axelbrons/NeuralSpeech/src/README.md

# Les codes sources du projet
Tous les codes sources Arduino et Python en vrac.  
GitHub avec des codes en plus par l'ECE : [https://github.com/ElectroniqueECE/Projet_ING3/tree/main]
