axelbrons/NeuralSpeech/src/python/readme_python.md

# Les fichiers python (réseau de neurones)
