axelbrons/NeuralSpeech/src/datasets/readme_dataset.md

# Les datasets utilisés pour le réseau de neurones
