axelbrons/NeuralSpeech/docs/schemas/readme_schema.md

# Les schémas pour la compréhension du projet
