axelbrons/NeuralSpeech/docs/images/4khz.png

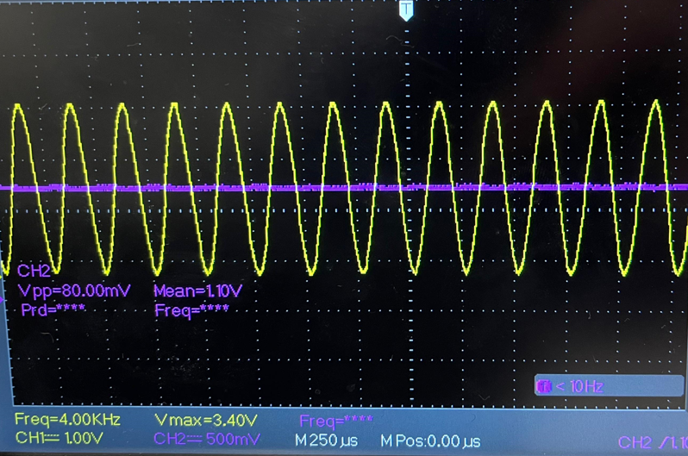
docs/images/4khz.png
