axelbrons/NeuralSpeech/docs/images/freq1.png

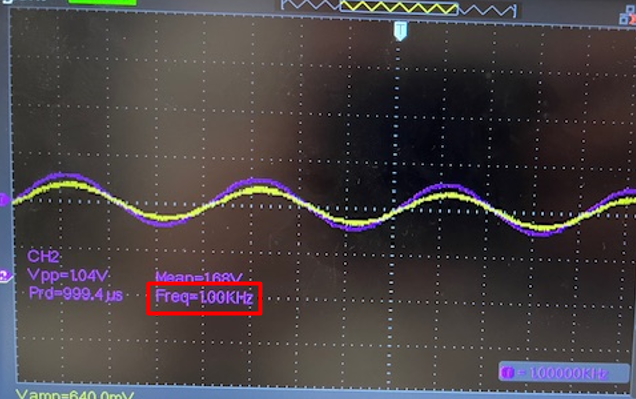
docs/images/freq1.png
