axelbrons/NeuralSpeech/docs/schemas/algo_cnn.png

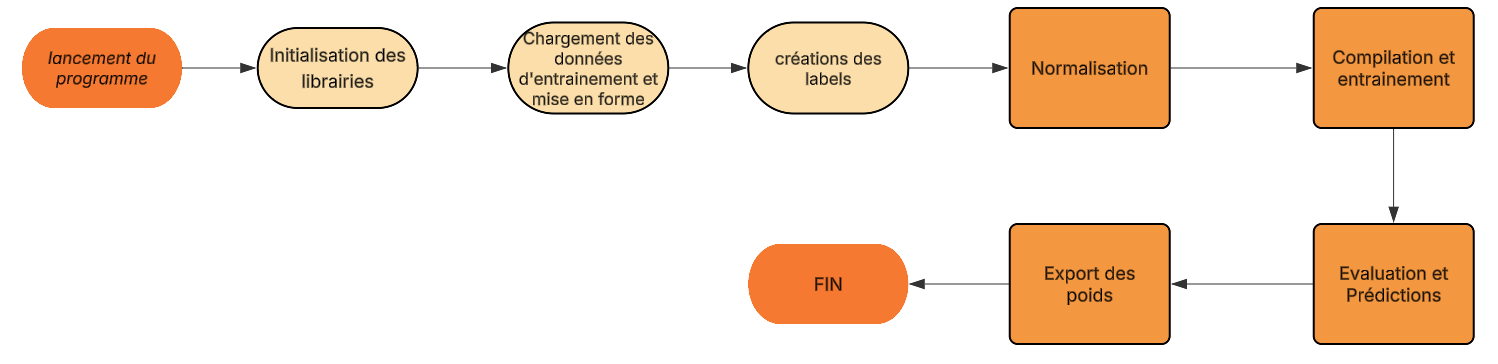
docs/schemas/algo_cnn.png
