axelbrons/NeuralSpeech/docs/schemas/algo_prediction.png

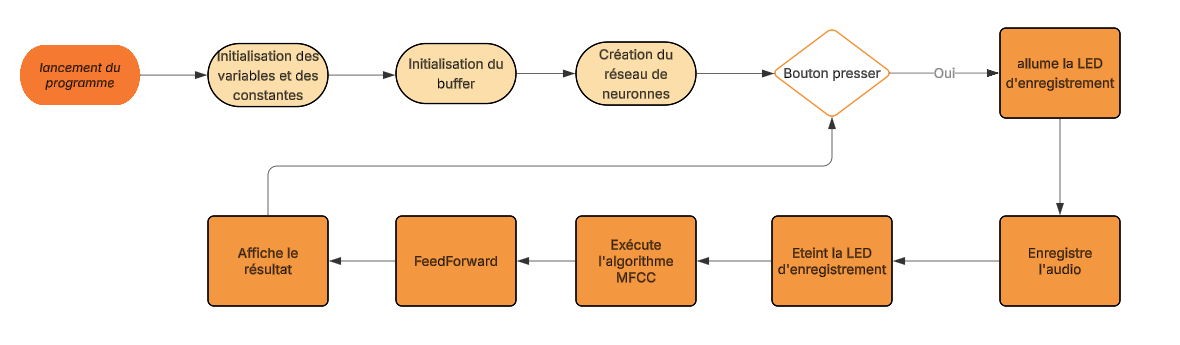
docs/schemas/algo_prediction.png
