axelbrons/NeuralSpeech/docs/schemas/algorigramme_enregistrement.png

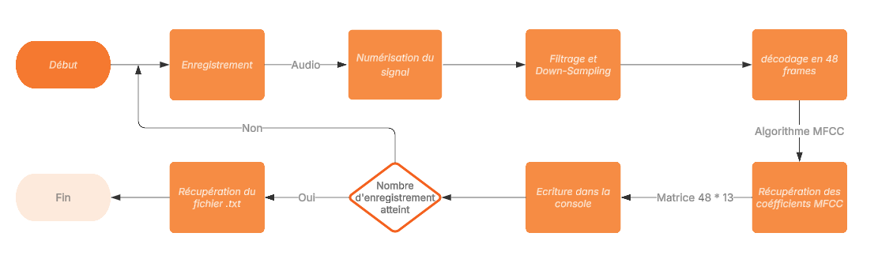
docs/schemas/algorigramme_enregistrement.png
