axelbrons/NeuralSpeech/docs/schemas/loss_1.png

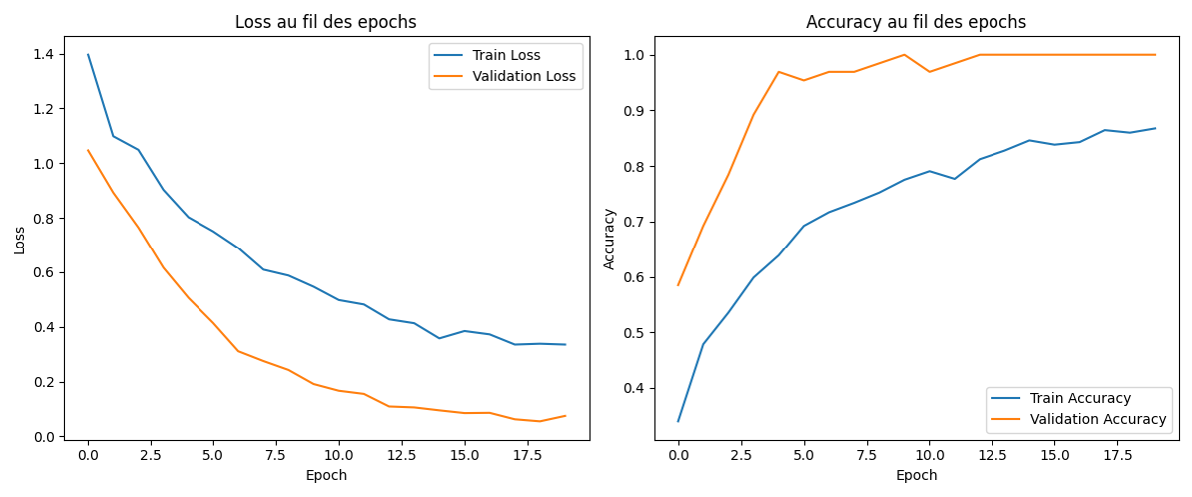
docs/schemas/loss_1.png
