axelbrons/NeuralSpeech/docs/schemas/recouvrement.jpg

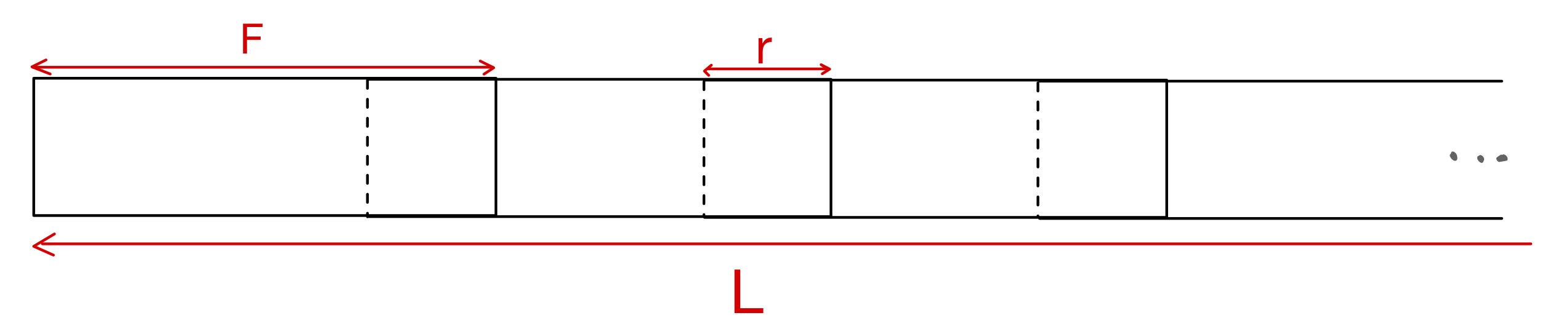
docs/schemas/recouvrement.jpg
