axelbrons/NeuralSpeech/docs/schemas/rif3.png

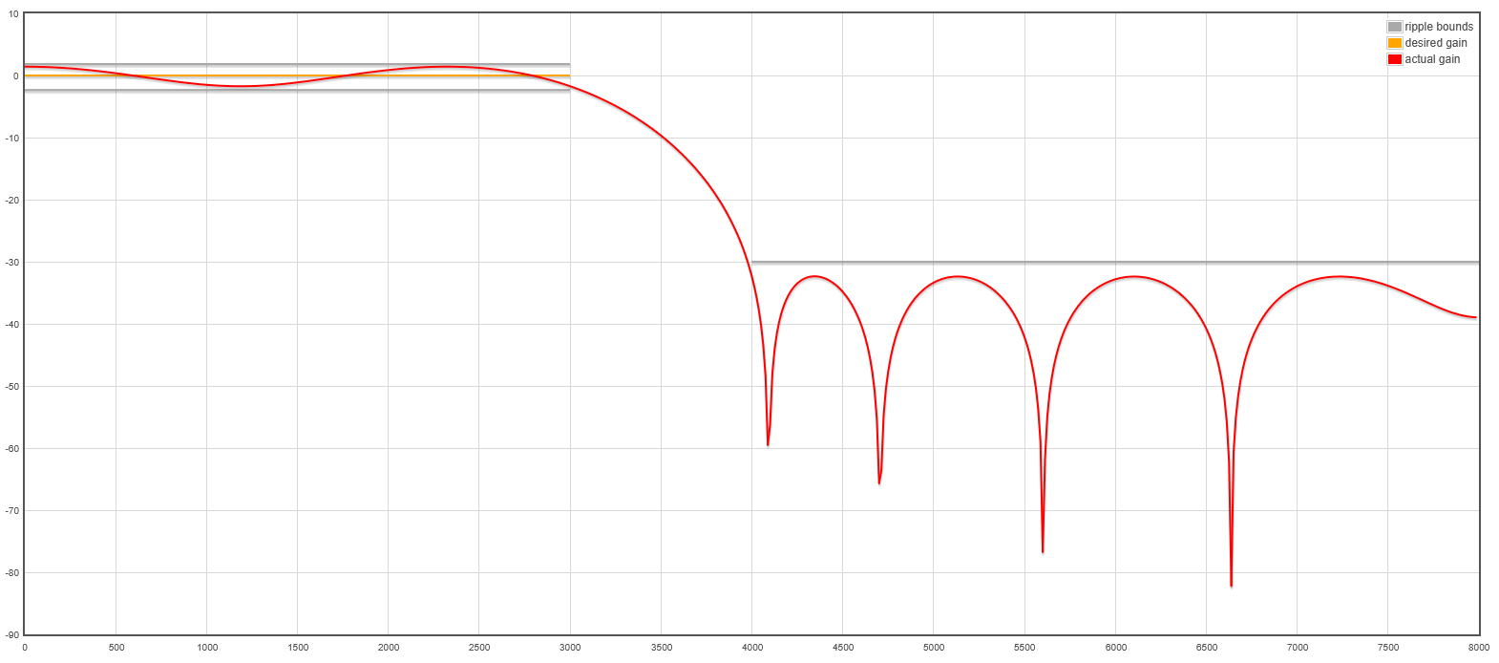
docs/schemas/rif3.png
