axelbrons/NeuralSpeech/docs/schemas/test_micro.png

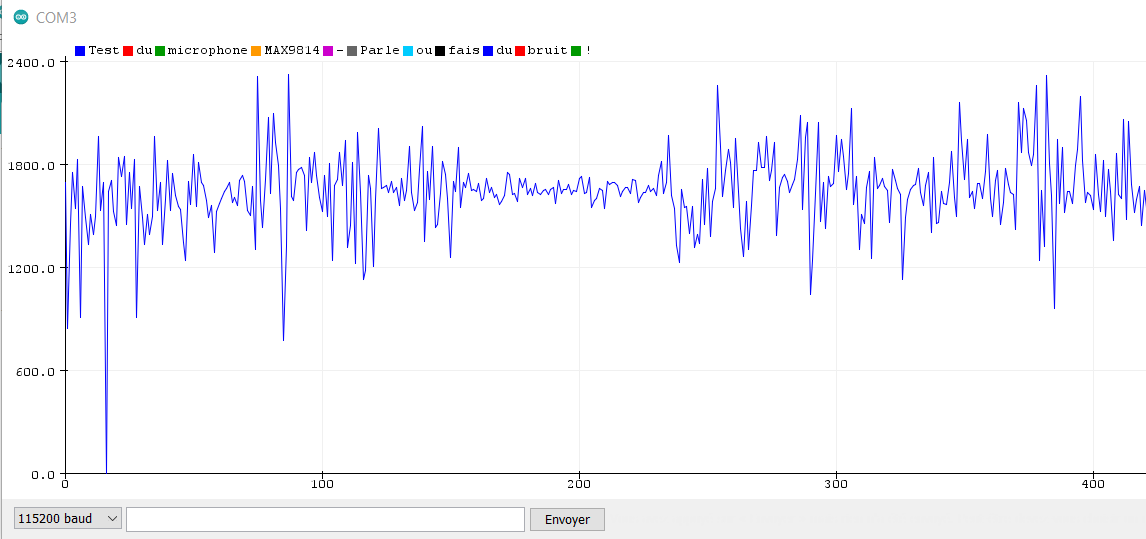
docs/schemas/test_micro.png
