axelbrons/NeuralSpeech/src/arduino/predictionV11.ino

#define RED_PIN 13
#define BLUE_PIN 10
#define GREEN_PIN 12
#define RAND_PIN 2
#define PIN1 9
#define PIN2 8
#define PIN3 7
#define PIN4 6
#define PIN5 5
#define PIN6 4
#define PIN7 3
#define PIN8 30
#define YELLOW_PIN 31
#define PIN_BUTTON 11

#define BUFFER_SIZE 33
#define RECORD_DURATION_MS 1000
#define SAMPLE_RATE 8000
#define SAMPLE_INTERVAL_DIV 4
#define NUM_SAMPLES (SAMPLE_RATE * RECORD_DURATION_MS / 1000)
#define FRAME_SIZE 256
#define NUM_FRAMES 48
#define HOP_SIZE 164

#define MFCC_SIZE 13
#define DCT_MFCC_SIZE 6

#define NumberOf(arg) ((unsigned int) (sizeof (arg) / sizeof (arg [0]))) // calculates the number of layers (in this case 3)
#define _1_OPTIMIZE 0B01000000 // Highly-Recommended Optimization For RAM
//#define _2_OPTIMIZE 0B01000000 // NO_BIAS 
//#define _3_OPTIMIZE 0B01000000 
//#define Softmax                 // Comment this line to use Sigmoid (the default) activation function
#define ACTIVATION__PER_LAYER
  #define ReLU
  #define Softmax


#include <NeuralNetwork.h>
#include "arduinoMFCC.h"
#include "cnn.h"

volatile bool isRecording = false;
volatile uint16_t recordIndex = 0;
volatile int16_t audioBuffer[NUM_SAMPLES];
float all_mfccs[NUM_FRAMES][MFCC_SIZE];

volatile float firBuffer[BUFFER_SIZE];
volatile int bufferIndex = 0;
volatile int downsampleCounter = 0;

const float firCoeffs[BUFFER_SIZE] = {
  -0.0012, -0.0023, -0.0036, -0.0047, -0.0051, -0.0039, 0.0000, 0.0073,
   0.0176, 0.0301, 0.0434, 0.0553, 0.0635, 0.0669, 0.0650, 0.0584,
   0.0485, 0.0368, 0.0248, 0.0136, 0.0041, -0.0027, -0.0065, -0.0074,
  -0.0062, -0.0039, -0.0016, -0.0003, 0.0002, 0.0001, 0.0000, 0.0000, 0.0000
};

arduinoMFCC mymfcc(MFCC_SIZE, DCT_MFCC_SIZE, FRAME_SIZE, SAMPLE_RATE);
float mfcc[MFCC_SIZE];

const unsigned int layers[] = {624,32,12,4};
byte Actv_Functions[] = {0,0,1};
float *estimation;

float biases[] = {
  -0.00959068,
  0.00044593,
  -0.01020757,
  0.01542411,
  0.00248082,
  -0.00622362,
  -0.00349902,
  0.00801347,
  0.01665884,
  0.03069334,
  -0.00152961,
  -0.00162340,
  0.00540355,
  0.06402886,
  -0.01762472,
  -0.01213219,
  0.04900601,
  -0.00760389,
  0.00523527,
  -0.00011670,
  0.01171703,
  0.03858143,
  -0.00899106,
  0.03103214,
  0.02638139,
  -0.01953445,
  0.00656504,
  -0.00912224,
  0.03171035,
  0.07587449,
  0.01880297,
  0.01502964,
  0.03340446,
  0.01285507,
  0.00388913,
  -0.01828738,
  -0.01797301,
  0.02213641,
  0.00687863,
  -0.01569228,
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
};

const float weights[] PROGMEM = {
  -0.04499208, 0.03271325, 0.05440304, 0.05619596, -0.05069192, 0.05624232, 0.05767090, -0.01795414, -0.04345380, -0.01770615, 0.00521532, 0.04855567, -0.00356791, 0.02554527, -0.04472741, 0.01578635, -0.06604491, -0.08006264, -0.05599805, 0.08681871, 0.03472689, 0.00778290, -0.06057338, 0.09660814, -0.00425629, 0.08296338, -0.06450947, -0.05790721, -0.03685900, 0.06651032, -0.02718071, 0.07119404, -0.01662575, -0.05664112, -0.07025507, 0.09713081, -0.02051932, 0.08815261, -0.08506606, -0.07992096, -0.00143222, -0.04898256, 0.05080562, -0.04492999, 0.03922189, -0.00923439, -0.04042747, -0.07867993, 0.05176881, 0.09047859, 0.05148749, 0.04937160, 0.00416793, 0.06177028, 0.02963247, -0.07111161, -0.07722872, -0.04044117, -0.01979455, 0.01218712, 0.04537714, 0.05358176, 0.08386775, 0.05966558, 0.03178202, -0.04754896, -0.03657506, -0.04874911, 0.00557783, -0.07357558, 0.03030180, -0.07215463, 0.10750002, 0.06794079, -0.05724789, 0.04963092, 0.01589831, 0.05398445, 0.09404478, 0.02325152, 0.00793550, 0.08994649, -0.07138925, 0.05361739, 0.07432745, 0.08080874, 0.02011331, 0.05636283, 0.01149643, -0.06436895, -0.07998374, 0.07825328, 0.09933892, 0.02166337, -0.04263704, 0.08750574, 0.00317000, 0.02020073, 0.09735423, -0.03127581, 0.08205047, -0.06593321, -0.00736241, 0.04499741, 0.06889585, 0.09294771, 0.09018651, 0.01878109, -0.07433867, 0.06674606, 0.05162749, 0.02427195, -0.09304856, -0.01734132, -0.05086859, -0.00420551, -0.07452306, -0.07436430, 0.02383018, 0.02600560, 0.0558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
    }

    digitalWrite(RAND_PIN, LOW); // Éteint la LED une fois terminé

    float inputMFCC[NUM_FRAMES][MFCC_SIZE]; // [48][13]
    float cnn_output[624]; // La sortie aplatie de cnn()
    float* output; // La sortie finale du réseau de neurones
    float* output2;
    int cmpt = 1;

    // 1. Remplir inputMFCC avec les MFCCs
    for (int f = 0; f < NUM_FRAMES; f++) {
      int start = f * HOP_SIZE;
      for (int i = 0; i < FRAME_SIZE; i++) {
        frames[f][i] = (float)audioBuffer[start + i];
      }
      //Serial.println((100*f)/48);
      if(f % 6 == 0){
        if(cmpt == 1){
          digitalWrite(PIN1, HIGH);
        }
        else if(cmpt == 2){
          digitalWrite(PIN2, HIGH);
        }
        else if(cmpt == 3){
          digitalWrite(PIN3, HIGH);
        }
        else if(cmpt == 4){
          digitalWrite(PIN4, HIGH);
        }
        else if(cmpt == 5){
          digitalWrite(PIN5, HIGH);
        }
        else if(cmpt == 6){
          digitalWrite(PIN6, HIGH);
        }
        else if(cmpt == 7){
          digitalWrite(PIN7, HIGH);
        }
        else if(cmpt == 8){
          digitalWrite(PIN8, HIGH);
        }
        cmpt++;
      }
      
      mymfcc.compute(frames[f], mfcc);

      for (int m = 0; m < MFCC_SIZE; m++) {
        inputMFCC[f][m] = normalize_sample(mfcc[m]);
      }
    }

    Serial.println(F("input mfcc finish"));

    // 2. Appliquer les convolutions + pooling
    //cnn(inputMFCC, cnn_output);
    // Flatten
    int index = 0;
    for (int i = 0; i < NUM_FRAMES; i++) {
      for (int j = 0; j < MFCC_SIZE; j++) {
        cnn_output[index++] = inputMFCC[i][j];
      }
    }
        
    Serial.println(F("cnn finish"));

    // 3. Feedforward dans le réseau de neurones
    output = NN.FeedForward(cnn_output);
    //output2 = NN2.FeedForward(cnn_output);
   
    // 4. Afficher la sortie

    if(output[0] > 0.7){
      digitalWrite(RED_PIN, HIGH);
      delay(1000);
      digitalWrite(RED_PIN, LOW);
    }
    else if (output[1] > 0.7){
      digitalWrite(BLUE_PIN, HIGH);
      delay(1000);
      digitalWrite(BLUE_PIN, LOW);
    }
    else if (output[2] > 0.7) {
      digitalWrite(GREEN_PIN, HIGH);
      delay(1000);
      digitalWrite(GREEN_PIN, LOW);
    }
    else if(output[3] > 0.7){
      digitalWrite(YELLOW_PIN, HIGH);
      delay(1000);
      digitalWrite(YELLOW_PIN, LOW);
    }
    else {
      digitalWrite(YELLOW_PIN, HIGH);
      delay(1000);
      digitalWrite(YELLOW_PIN, LOW);
    }
    /*
    else if (output[3] > 0.5) {
      digitalWrite(RAND_PIN, HIGH);
      delay(1000);
      digitalWrite(RAND_PIN, LOW);
    }*/
    digitalWrite(PIN1, LOW);
    digitalWrite(PIN2, LOW);
    digitalWrite(PIN3, LOW);
    digitalWrite(PIN4, LOW);
    digitalWrite(PIN5, LOW);
    digitalWrite(PIN6, LOW);
    digitalWrite(PIN7, LOW);
    digitalWrite(PIN8, LOW);
    cmpt = 1;

    
    for(int i = 0; i < 4 ; i++){
      Serial.println(output[i], 7);
    }
  }
}
/*
    // Prédiction avec réseau de neurones
    float* output = NN.FeedForward(nn_input); // Remplace NN par ton instance de réseau
    Serial.println(output[0], 7);             // Affiche la prédiction avec 7 chiffres après la virgule
    */



void TC0_Handler() {
  TC_GetStatus(TC0, 0);
  uint16_t rawSample = analogRead(A0);
  firBuffer[bufferIndex] = rawSample;
  bufferIndex = (bufferIndex + 1) % BUFFER_SIZE;

  downsampleCounter++;
  if (downsampleCounter >= SAMPLE_INTERVAL_DIV) {
    downsampleCounter = 0;

    float filtered = 0;
    int idx = bufferIndex;
    for (int i = 0; i < BUFFER_SIZE; i++) {
      idx = (idx != 0) ? idx - 1 : BUFFER_SIZE - 1;
      filtered += firBuffer[idx] * firCoeffs[i];
    }

    if (isRecording && recordIndex < NUM_SAMPLES) {
      audioBuffer[recordIndex++] = (int16_t)filtered;
      if (recordIndex >= NUM_SAMPLES) {
        isRecording = false;
      }
    }
  }
}
